sharp541/ocean_nest32/freecad/left.FCStd

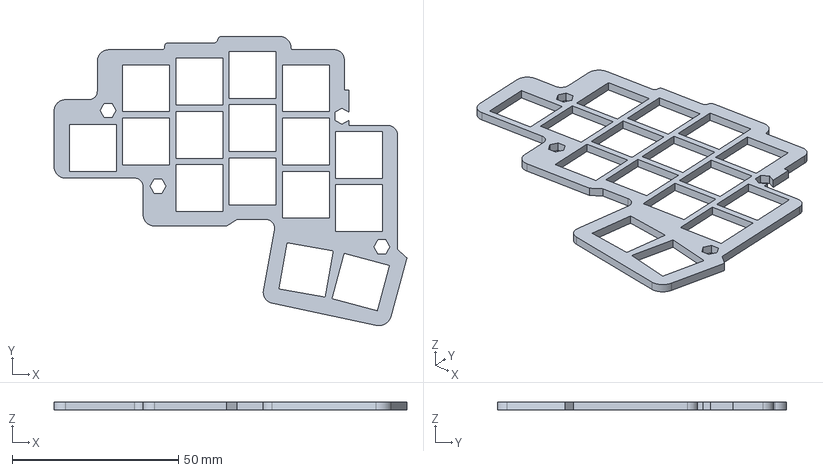
[picture p1: CAD file, 2026-04-10]
freecad/left.FCStd
106.1 x 86.9 x 2.30 mm
