sharp541/ocean_nest32/freecad/right.FCStd

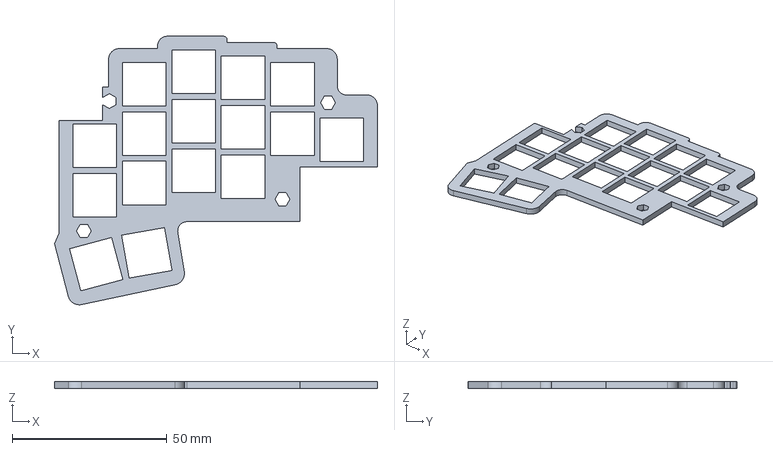
[picture p2: CAD file, 2026-04-10]
freecad/right.FCStd
104.5 x 86.9 x 2.30 mm
