sharp541/ocean_nest32/kicad/OceanNest_L/OceanNest_L.kicad_pcb

## KiCad design kicad/OceanNest_L/OceanNest_L.kicad_pcb (2026-10-14)

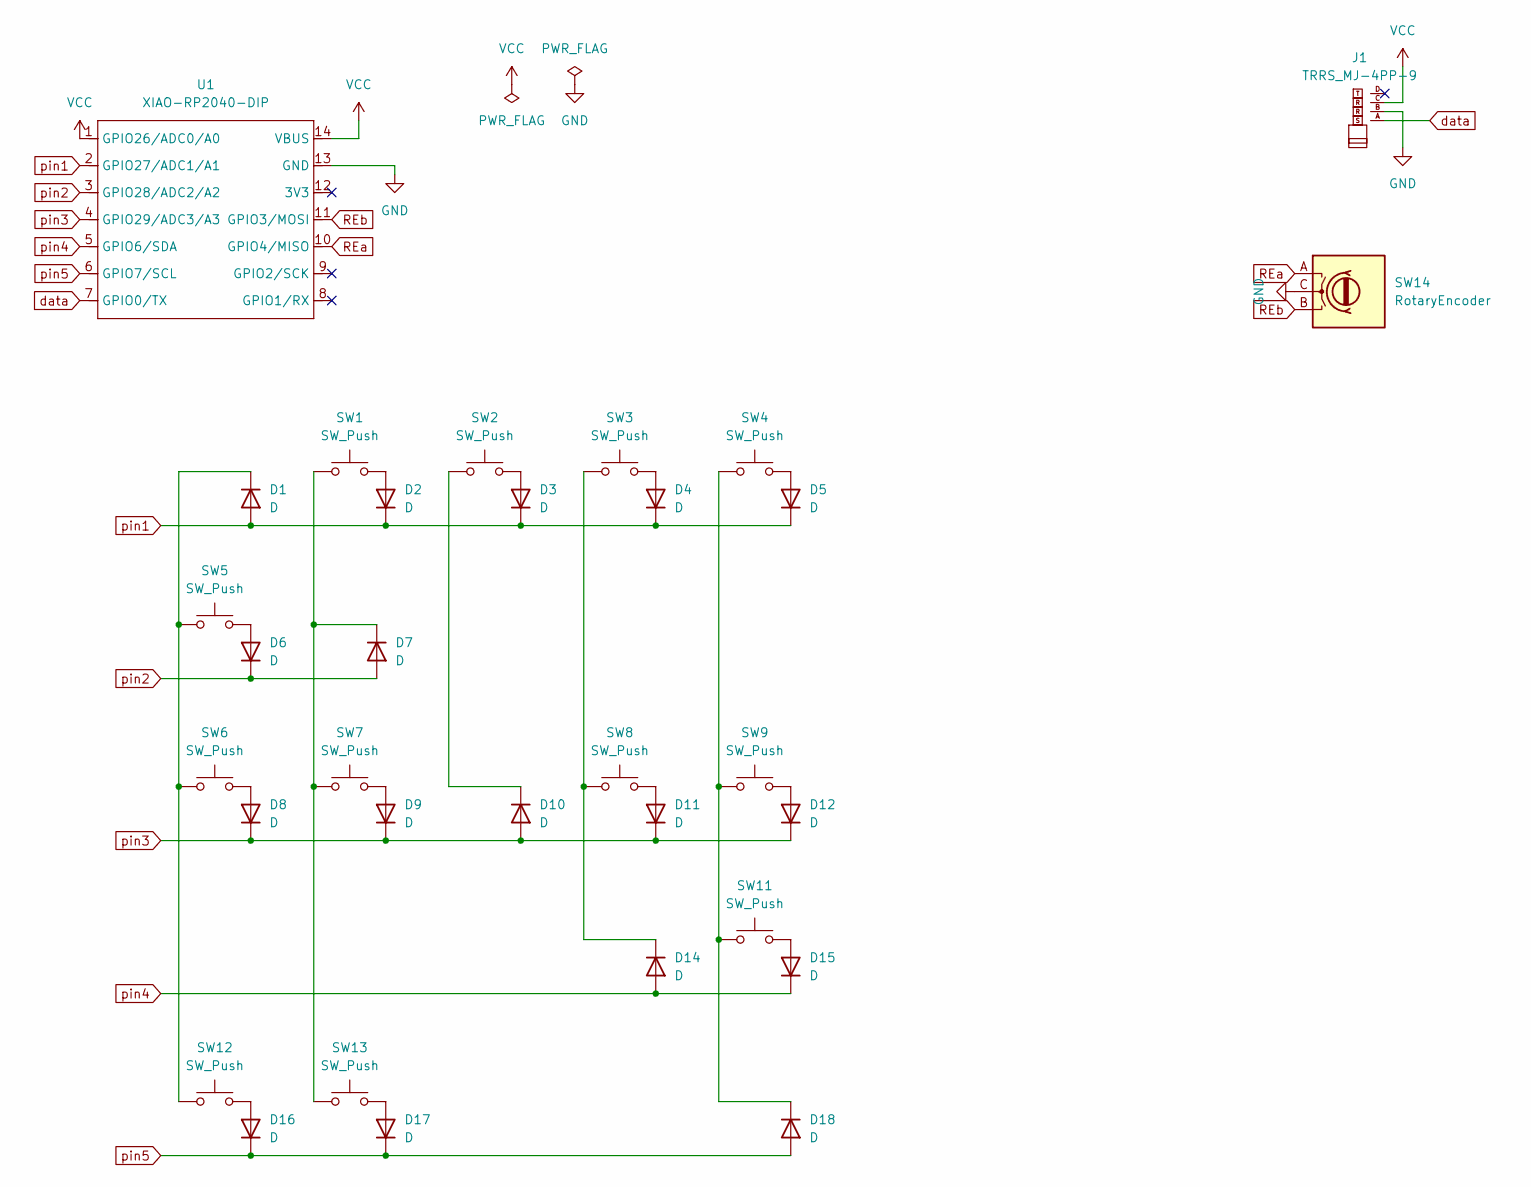
[picture p3: schematic OceanNest_L.kicad_sch]

Parts:
D1, D2, D3, D4, D5, D6, D7, D8, D9, D10, D11, D12, D14, D15, D16, D17, D18: D; Diode_SMD
J1: TRRS_MJ-4PP-9
SW1, SW2, SW3, SW4, SW5, SW6, SW7, SW8, SW9, SW11, SW12, SW13: SW_Push; CherryMX_Hotswap_16m
SW14: RotaryEncoder; RotaryEncoder_Alps_EC12E_Vertical_H20mm
U1: XIAO-RP2040-DIP; XIAO-RP2040-TH

Connections:
GND: J1.B, SW14.C, U1.13 (GND)
unnamed: D1.1 (K), SW5.1, SW6.1, SW12.1
unnamed: D2.2 (A), SW1.2
unnamed: D3.2 (A), SW2.2
unnamed: D4.2 (A), SW3.2
unnamed: D5.2 (A), SW4.2
unnamed: D6.2 (A), SW5.2
unnamed: D7.1 (K), SW1.1, SW7.1, SW13.1
unnamed: D8.2 (A), SW6.2
unnamed: D9.2 (A), SW7.2
unnamed: D10.1 (K), SW2.1
unnamed: D11.2 (A), SW8.2
unnamed: D12.2 (A), SW9.2
unnamed: D14.1 (K), SW3.1, SW8.1
unnamed: D15.2 (A), SW11.2
unnamed: D16.2 (A), SW12.2
unnamed: D17.2 (A), SW13.2
unnamed: D18.1 (K), SW4.1, SW9.1, SW11.1
REa: SW14.A, U1.10 (GPIO4/MISO)
REb: SW14.B, U1.11 (GPIO3/MOSI)
VCC: J1.C, U1.1 (GPIO26/ADC0/A0), U1.14 (VBUS)
data: J1.A, U1.7 (GPIO0/TX)
pin1: D1.2 (A), D2.1 (K), D3.1 (K), D4.1 (K), D5.1 (K), U1.2 (GPIO27/ADC1/A1)
pin2: D6.1 (K), D7.2 (A), U1.3 (GPIO28/ADC2/A2)
pin3: D8.1 (K), D9.1 (K), D10.2 (A), D11.1 (K), D12.1 (K), U1.4 (GPIO29/ADC3/A3)
pin4: D14.2 (A), D15.1 (K), U1.5 (GPIO6/SDA)
pin5: D16.1 (K), D17.1 (K), D18.2 (A), U1.6 (GPIO7/SCL)

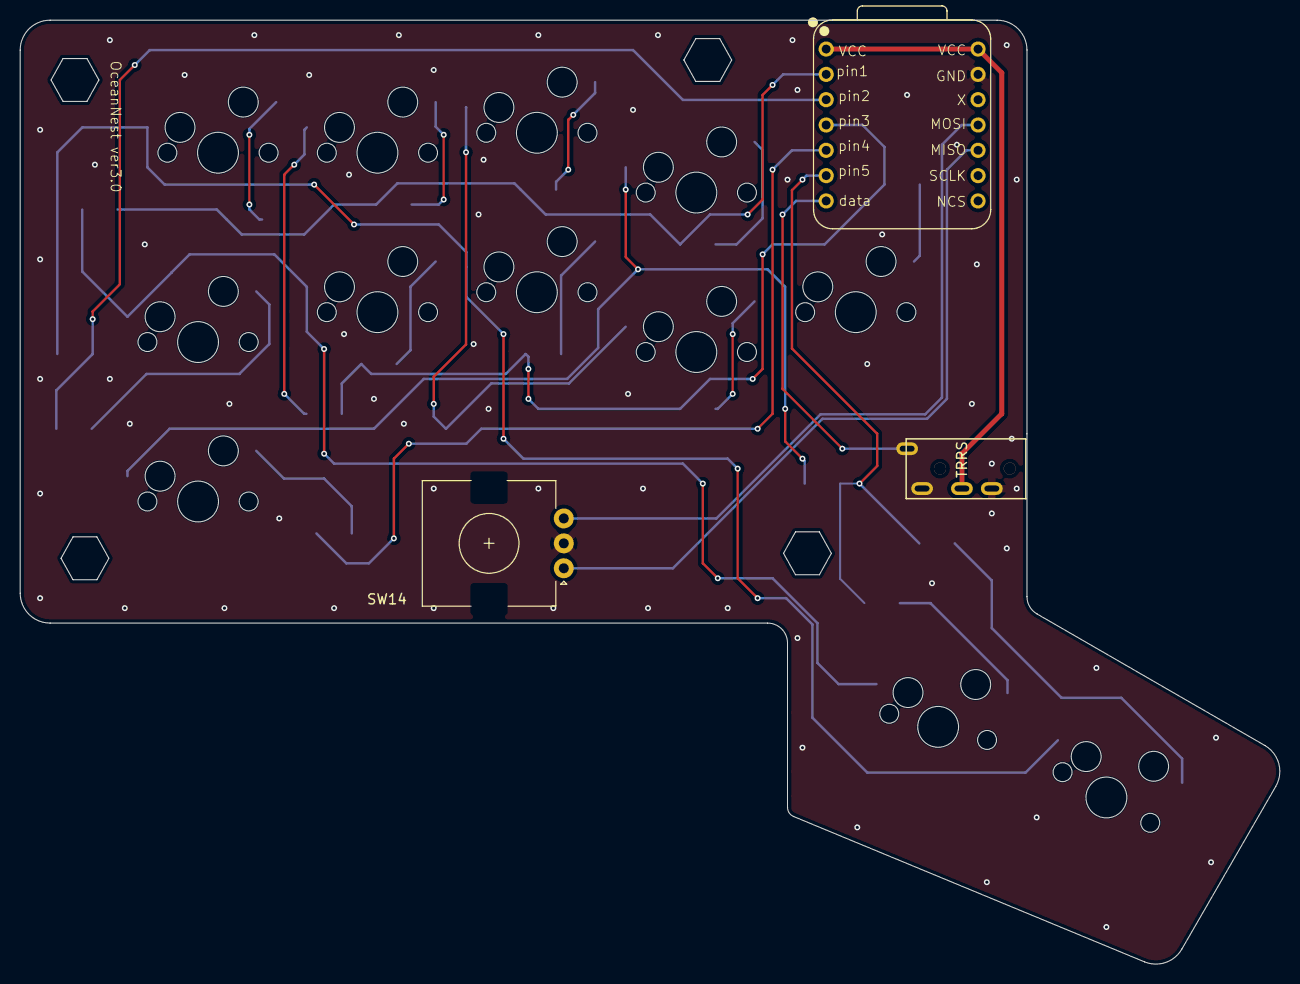
[picture p4: board OceanNest_L.kicad_pcb from above]

Board: 2 copper layers, 126.4 x 94.7 mm, 38 parts (1 on the bottom side), 27 nets.

Other parts of the board:
hole1, hole2, hole2#2, hole2#3: Val**; m2_Spacer_Hole_hex
hole3, hole4: Val**; m2_Screw_Hole
