sharp541/ocean_nest32/kicad/OceanNest_R/OceanNest_R.kicad_pcb

## KiCad design kicad/OceanNest_R/OceanNest_R.kicad_pcb (2026-10-14)

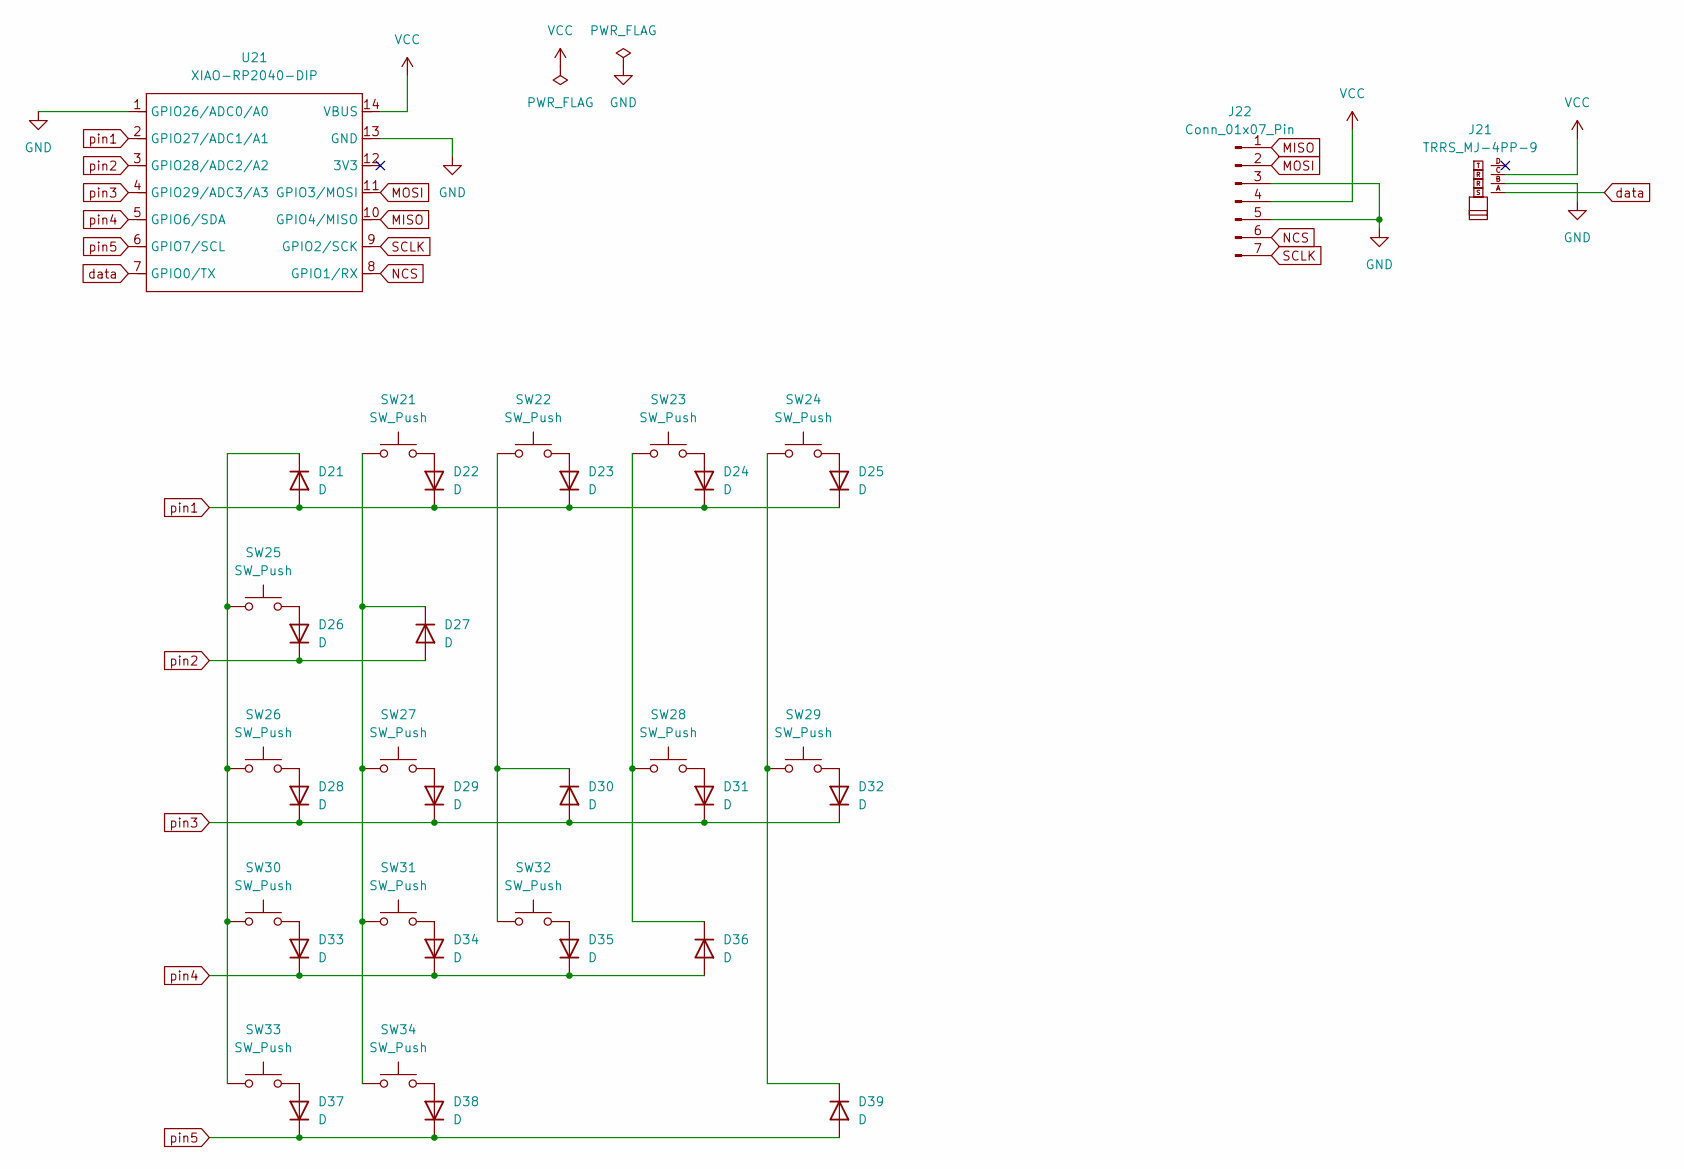
[picture p5: schematic OceanNest_R.kicad_sch]

Parts:
D21, D22, D23, D24, D25, D26, D27, D28, D29, D30, D31, D32, D33, D34, D35, D36, D37, D38, D39: D; Diode_SMD
J21: TRRS_MJ-4PP-9; MJ-4PP-9
J22: Conn_01x07_Pin; Mac8_L_7pin_contact_NEW2023
SW21, SW22, SW23, SW24, SW25, SW26, SW27, SW28, SW29, SW30, SW31, SW32, SW33, SW34: SW_Push; CherryMX_Hotswap_16m
U21: XIAO-RP2040-DIP

Connections:
GND: J21.B, J22.3, J22.5, U21.1 (GPIO26/ADC0/A0), U21.13 (GND)
MISO: J22.1, U21.10 (GPIO4/MISO)
MOSI: J22.2, U21.11 (GPIO3/MOSI)
NCS: J22.6, U21.8 (GPIO1/RX)
unnamed: D21.1 (K), SW25.1, SW26.1, SW30.1, SW33.1
unnamed: D22.2 (A), SW21.2
unnamed: D23.2 (A), SW22.2
unnamed: D24.2 (A), SW23.2
unnamed: D25.2 (A), SW24.2
unnamed: D26.2 (A), SW25.2
unnamed: D27.1 (K), SW21.1, SW27.1, SW31.1, SW34.1
unnamed: D28.2 (A), SW26.2
unnamed: D29.2 (A), SW27.2
unnamed: D30.1 (K), SW22.1, SW32.1
unnamed: D31.2 (A), SW28.2
unnamed: D32.2 (A), SW29.2
unnamed: D33.2 (A), SW30.2
unnamed: D34.2 (A), SW31.2
unnamed: D35.2 (A), SW32.2
unnamed: D36.1 (K), SW23.1, SW28.1
unnamed: D37.2 (A), SW33.2
unnamed: D38.2 (A), SW34.2
unnamed: D39.1 (K), SW24.1, SW29.1
SCLK: J22.7, U21.9 (GPIO2/SCK)
VCC: J21.C, J22.4, U21.14 (VBUS)
data: J21.A, U21.7 (GPIO0/TX)
pin1: D21.2 (A), D22.1 (K), D23.1 (K), D24.1 (K), D25.1 (K), U21.2 (GPIO27/ADC1/A1)
pin2: D26.1 (K), D27.2 (A), U21.3 (GPIO28/ADC2/A2)
pin3: D28.1 (K), D29.1 (K), D30.2 (A), D31.1 (K), D32.1 (K), U21.4 (GPIO29/ADC3/A3)
pin4: D33.1 (K), D34.1 (K), D35.1 (K), D36.2 (A), U21.5 (GPIO6/SDA)
pin5: D37.1 (K), D38.1 (K), D39.2 (A), U21.6 (GPIO7/SCL)

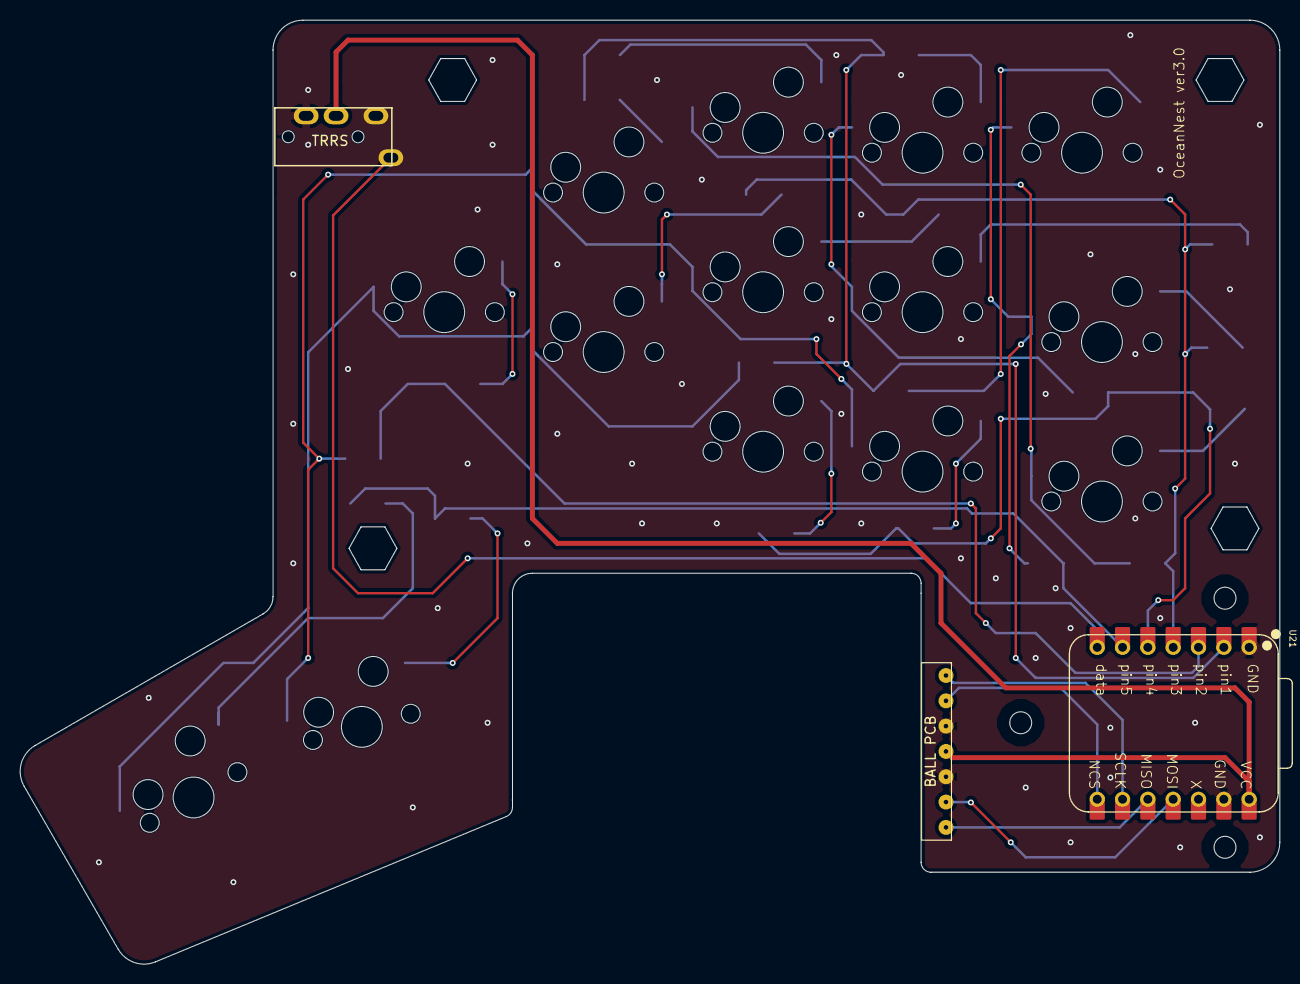
[picture p6: board OceanNest_R.kicad_pcb from above]

Board: 2 copper layers, 126.4 x 94.7 mm, 43 parts (1 on the bottom side), 31 nets.

Other parts of the board:
hole1, hole1#2, hole2, hole2#2: Val**; m2_Spacer_Hole_hex
sc0, sc1, sc2: Val**; m2_Screw_Hole
