sharp541/ocean_nest32/qmk_firmware/ocean_nest32/keymaps/default/config.h

// hardware configuration
#define SERIAL_USART_TX_PIN GP0

#define SPLIT_POINTING_ENABLE
#define POINTING_DEVICE_RIGHT
#define SPI_DRIVER SPID0
#define SPI_SCK_PIN GP2
#define SPI_MOSI_PIN GP3
#define SPI_MISO_PIN GP4
#define PMW33XX_CS_PIN GP1
#define PMW3610_CS_PIN GP1
#define PMW3610_SCLK_PIN GP2
#define PMW3610_SDIO_PIN GP3

// trackball configuration

#define POINTING_DEVICE_ROTATION_270
#define POINTING_DEVICE_INVERT_Y
#define PMW33XX_CPI 12000
#define PMW3610_CPI 3200
#define POINTING_DEVICE_HIRES_SCROLL_ENABLE
#define POINTING_DEVICE_HIRES_SCROLL_MULTIPLIER 127
#define POINTING_DEVICE_HIRES_SCROLL_EXPONENT 0
#define MOUSEKEY_WHEEL_DELTA 127

// software configuration

#define BOOTMAGIC_ROW 1
#define BOOTMAGIC_COLUMN 0
#define BOOTMAGIC_ROW_RIGHT 7
#define BOOTMAGIC_COLUMN_RIGHT 4

#define TAP_CODE_DELAY 5
#define TAPPING_TERM 130
#define HOLD_ON_OTHER_KEY_PRESS

#define COMBO_STRICT_TIMER
#define COMBO_TERM 50

#define AUTO_SHIFT_TIMEOUT 200
#define NO_AUTO_SHIFT_SPECIAL
#define NO_AUTO_SHIFT_NUMERIC
#define NO_AUTO_SHIFT_ALPHA
#define CAPS_WORD_INVERT_ON_SHIFT
