sharp541/ocean_nest32/(commit log)

2025-09-04 config: add SPI and pointing device configurations
2025-09-04 update: enhance SPI and pointing device support, add halconf and mcuconf configurations
2025-09-08 feat: add KiCad PCB and schematic files for OceanNest project, including top and bottom layers
    [OceanNest_L.kicad_pcb, OceanNest_L.kicad_sch, OceanNest_L_top.kicad_pcb, OceanNest_L_top.kicad_sch, OceanNest_R.kicad_pcb, OceanNest_R.kicad_sch, OceanNest_R_top.kicad_pcb, OceanNest_R_top.kicad_sch]
2025-09-09 feat: add DXF edge cuts file and update PCB properties for OceanNest project
    [OceanNest_L_top-Edge_Cuts.dxf, OceanNest_L_top.kicad_pcb]
2025-09-09 refactor: update PCB properties and footprints for OceanNest project, including footprint layer changes and model path adjustments
    [OceanNest_L.kicad_pcb, OceanNest_L_top.kicad_pcb, OceanNest_R_top.kicad_pcb]
2025-09-09 chore: update .gitignore to include additional CAD file types and remove obsolete DXF edge cuts file
    [OceanNest_L_top-Edge_Cuts.dxf]
2025-09-13 feat: add new FreeCAD files and update PCB properties for OceanNest project, including layer selection and output format adjustments
    [OceanNest_L.kicad_pcb, OceanNest_R.kicad_pcb, left.FCStd, right.FCStd]
2025-09-13 fix: update tapping term and combo term values in config.h for improved key response
    [config.h]
2025-09-14 fix: update keymap for mouse layer to improve functionality with new key definitions and shortcuts
    [keymap.c]
2025-09-22 feat: update esc combo key definition for improved keymap functionality
2025-10-03 feat: add mouse button functionality to keymap for enhanced control
2025-11-24 feat: update PCB and schematic files for OceanNest project, including new components and layout adjustments
    [OceanNest_L.kicad_pcb, OceanNest_L.kicad_sch, OceanNest_L_top.kicad_pcb, OceanNest_L_top.kicad_sch, OceanNest_R.kicad_pcb, OceanNest_R_Bottom.kicad_pcb, OceanNest_R_Bottom.kicad_sch, OceanNest_R_top.kicad_pcb]
2025-11-24 feat: add new PCB and schematic files for OceanNest_L and OceanNest_L_Bottom, including layout adjustments and component updates
    [OceanNest_L.kicad_pcb, OceanNest_L_Bottom.kicad_pcb, OceanNest_L_Bottom.kicad_sch, OceanNest_L_Top.kicad_pcb, OceanNest_L_Top.kicad_sch, OceanNest_R.kicad_pcb]
2025-11-25 feat: add rotary encoder configuration for enhanced input control
2025-11-26 feat: update keymap layers and add encoder map for enhanced functionality
2025-12-01 feat: update keyboard configuration with new PID/VID and enable bootmagic for enhanced functionality
2025-12-20 feat: update pointing device configuration to PMW3610 and adjust rotation settings for improved tracking
2025-12-20 fix: update filenames and step files in OceanNest project for consistency and clarity
    [OceanNest_R.kicad_pcb, OceanNest_R_Bottom.kicad_pcb]
2025-12-21 fix: update pointing device driver to PMW3360 and adjust rotation settings for improved tracking accuracy
    [config.h, keymap.c]
2025-12-21 fix: update encoder resolution to improve rotary input responsiveness
2026-01-08 fix: adjust autoshift behavior and keymap configurations for improved functionality
    [config.h, keymap.c]
2026-01-09 fix: update keymap configurations for improved functionality and mouse layer adjustments
    [keymap.c]
2026-01-09 fix: correct key assignments in default keymap for improved functionality
    [keymap.c]
2026-01-20 fix: update PID in keyboard.json and refine key assignments in default keymap for improved functionality
    [keymap.c]
2026-01-21 fix: update combo definitions and key assignments for improved functionality
    [keymap.c]
2026-01-22 fix: update bootmagic configuration and refine encoder mappings for improved functionality
    [config.h, keymap.c]
2026-01-22 feat: add new OceanNest_L and OceanNest_R PCB and project files for enhanced design capabilities
    [OceanNest_L.kicad_pcb, OceanNest_L.kicad_sch, OceanNest_L_Bottom.kicad_pcb, OceanNest_L_Top.kicad_pcb, OceanNest_L_micon.kicad_pcb, OceanNest_R.kicad_pcb, OceanNest_R.kicad_sch, OceanNest_R_Bottom.kicad_pcb]
2026-01-23 fix: adjust layer count, update combo definitions, and refine key assignments for improved functionality
    [keymap.c]
2026-01-23 fix: refine key assignments in default keymap for improved functionality
    [keymap.c]
2026-02-24 fix: update combo definitions and key assignments for consistency and improved functionality
    [keymap.c]
2026-02-24 fix: update mouse layer key assignments for improved functionality
    [keymap.c]
2026-02-24 fix: rename combo variables for consistency in keymap definitions
    [keymap.c]
2026-03-09 fix: adjust tapping and combo timing for improved responsiveness
    [config.h, keymap.c]
2026-04-10 fix scroll sensitivity after qmk update
    [config.h]
2026-09-02 Update right PCB layout and PMW3610 design notes
    [OceanNest_R_top.kicad_pcb]
2026-09-02 Refine top cover board outline
    [OceanNest_R_top.kicad_pcb]
2026-09-02 Adjust right top cover board geometry
    [OceanNest_R_top.kicad_pcb]
2026-09-03 prepare outline
    [OceanNest_R.kicad_pcb, OceanNest_R_top.kicad_pcb]
2026-09-04 Consolidate KiCad projects
    [OceanNest_L_Bottom.kicad_pcb, OceanNest_L_Bottom.kicad_sch, OceanNest_L_Top.kicad_sch, OceanNest_R_Bottom.kicad_pcb, OceanNest_R_Bottom.kicad_sch, OceanNest_R_top.kicad_pcb, OceanNest_R_top.kicad_sch]
